Maduranga628/counter-and-collector/Pearl_Weave/Collector_small/collector_small_3D.step

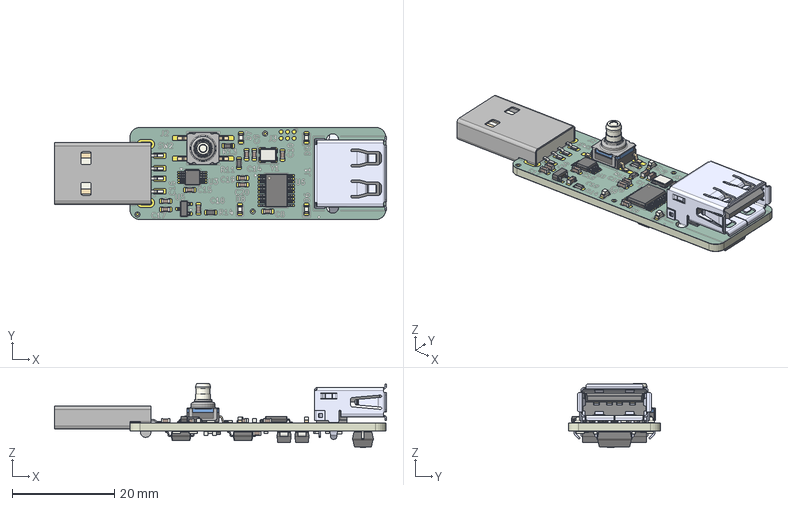
[picture p1: CAD file, 2026-06-02]
Pearl_Weave/Collector_small/collector_small_3D.step
64.8 x 18.0 x 12.6 mm
C_0603_1608Metric x 13
R_0603_1608Metric x 11
LED_0603_1608Metric x 4
SOT-23
USB-A1HSW6
MSOP-10_3x3mm_P0.5mm
USB_A_CNCTech_1001-011-01101_Horizontal
TSSOP-20_4.4x6.5mm_P0.65mm
SW_Push_1P1T_NO_CK_KSC9xxG
Crystal_SMD_3225-4Pin_3.2x2.5mm
D_SOD_523
SOIC-14_3.9x8.7mm_P1.27mm
D_SMA x 3
Fuse_1206_3216Metric x 2
SOIC-8_3.9x4.9mm_P1.27mm
SW_DIP_SPSTx01_Slide_67x41mm_W673mm_P254mm_LowProfile_JPin
Collector_copper
Collector_silkscreen x 2
Collector_soldermask x 2
Collector_PCB
