Maduranga628/counter-and-collector/Pearl_Weave/Counter/Counter.kicad_pcb

## KiCad design Pearl_Weave/Counter/Counter.kicad_pcb (2026-06-02)

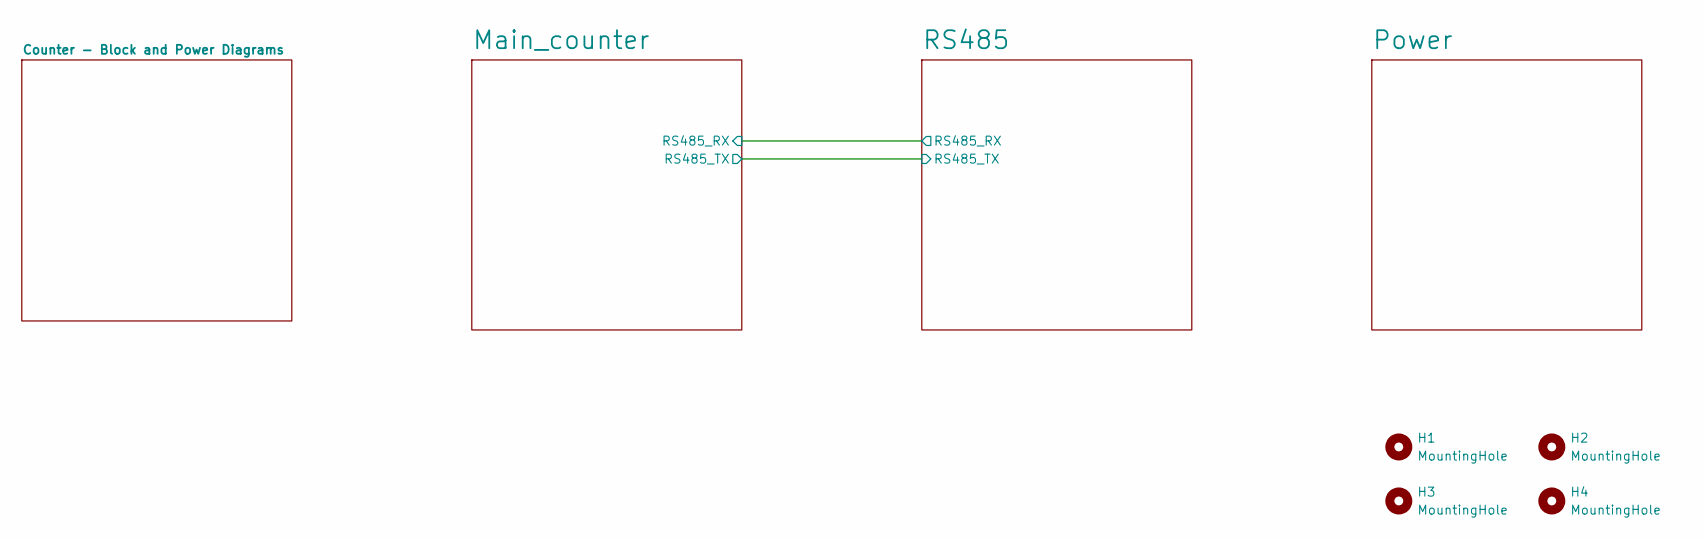
[picture p2: schematic Counter.kicad_sch]

Parts:
H1, H2, H3, H4: MountingHole; MountingHole_3.2mm_M3

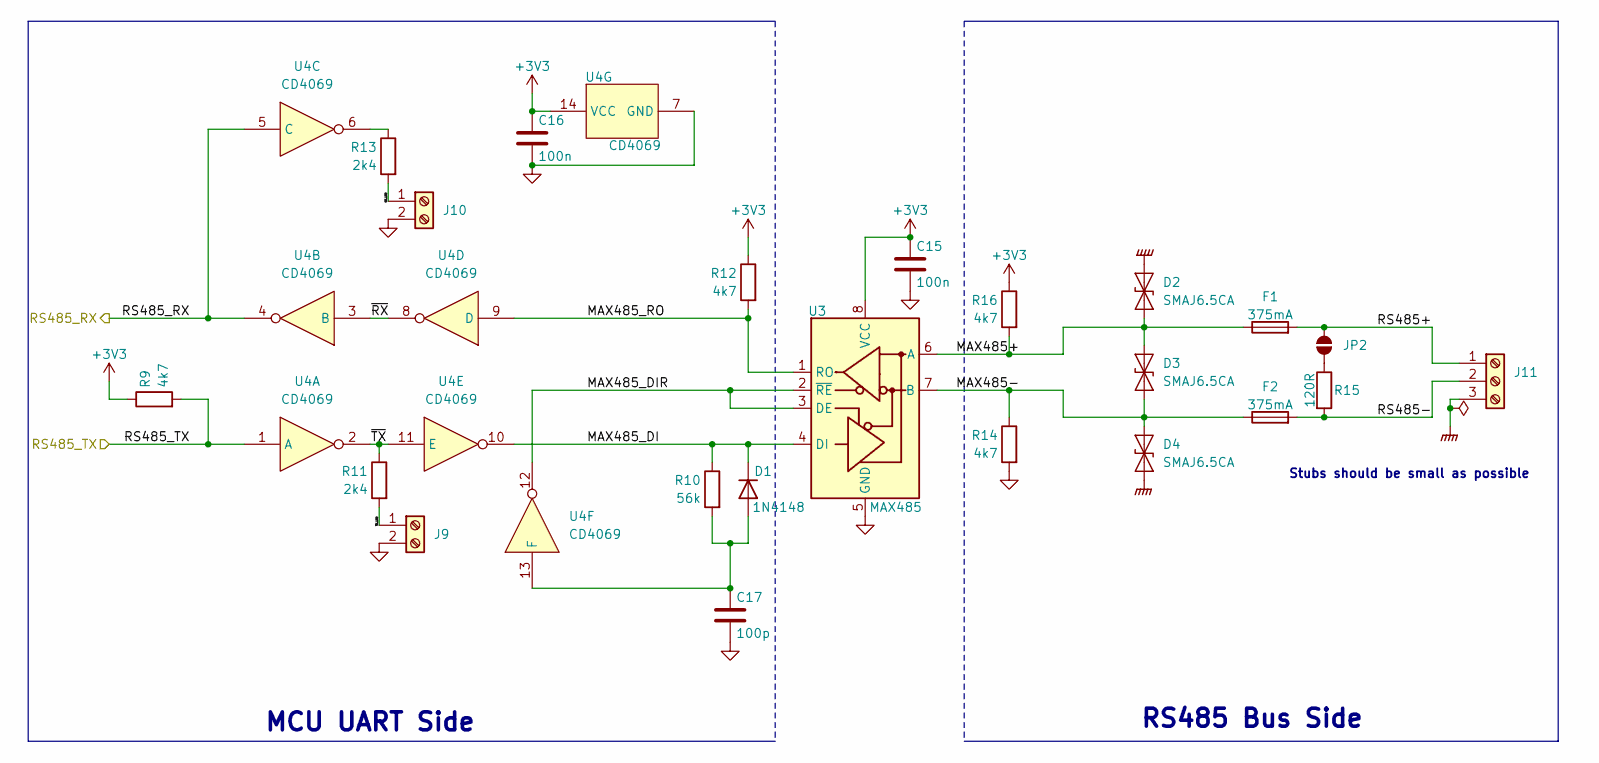
[picture p3: schematic RS485.kicad_sch]

Parts:
C15, C16: 100n; C_0603_1608Metric; Manufacturer Part Number CC0603MRX7R7BB104; LCSC Part Number C2172848
C17: 100p; C_0603_1608Metric; Manufacturer Part Number CC0603FRNPO9BN101; LCSC Part Number C513648
D1: 1N4148; D_SOD-523; Manufacturer Part Number 1N4148WT; LCSC Part Number C917006
D2, D3, D4: SMAJ6.5CA; D_SMA; Manufacturer Part Number SMAJ6.5CA; LCSC Part Number C54318614
F1, F2: 375mA; Fuse_1206_3216Metric; Manufacturer Part Number F12F0.375TH; LCSC Part Number C41398705
J9, J10: Screw_Terminal_01x02; TerminalBlock_Phoenix_MPT-0,5-2-2.54_1x02_P2.54mm_Horizontal
J11: Screw_Terminal_01x03; TerminalBlock_Phoenix_MPT-0,5-3-2.54_1x03_P2.54mm_Horizontal
JP2: SolderJumper_2_Open; SolderJumper-2_P1.3mm_Open_RoundedPad1.0x1.5mm
R9, R12, R14, R16: 4k7; R_0603_1608Metric; Manufacturer Part Number RC0603FR-074K7L; LCSC Part Number C99782
R10: 56k; R_0603_1608Metric; Manufacturer Part Number RC0603FR-0756KL; LCSC Part Number C114630
R11, R13: 2k4; R_0603_1608Metric; Manufacturer Part Number RC0603FR-072K4L; LCSC Part Number C114611
R15: 120R; R_0603_1608Metric; Manufacturer Part Number RC0603FR-07120RL; LCSC Part Number C114640
U3: MAX485; SOIC-8_3.9x4.9mm_P1.27mm; Manufacturer Part Number MAX485CSA+T-JSM; LCSC Part Number C18195057
U4: CD4069; SOIC-14_3.9x8.7mm_P1.27mm; Manufacturer Part Number CD4069; LCSC Part Number C3041279

Connections:
+3V3: C15.1, C16.1, R9.1, R12.1, R16.1, U3.8 (VCC), U4.14 (VCC); also elsewhere on the board
/Main_counter/RS485_RX: U4.4, U4.5 (C); also elsewhere on the board
/Main_counter/RS485_TX: R9.2, U4.1 (A); also elsewhere on the board
/RS485/MAX485+: D2.1 (A1), D3.2 (A2), F1.1, R16.2, U3.6 (A)
/RS485/MAX485-: D3.1 (A1), D4.2 (A2), F2.1, R14.1, U3.7 (B)
/RS485/MAX485_DI: D1.1 (K), R10.1, U3.4 (DI), U4.10
/RS485/MAX485_DIR: U3.2 (~RE), U3.3 (DE), U4.12
/RS485/MAX485_RO: R12.2, U3.1 (RO), U4.9 (D)
/RS485/RS485+: F1.2, J11.1, JP2.2 (B)
/RS485/RS485-: F2.2, J11.2, R15.2
/RS485/RX_LED: J10.1, R13.2
/RS485/TX_LED: J9.1, R11.2
/RS485/~RX: U4.3 (B), U4.8
/RS485/~TX: R11.1, U4.2, U4.11 (E)
GND: C15.2, C16.2, C17.2, J9.2, J10.2, R14.2, U3.5 (GND), U4.7 (GND); also elsewhere on the board
GNDPWR: D2.2 (A2), D4.1 (A1), J11.3
unnamed: C17.1, D1.2 (A), R10.2, U4.13 (F)
unnamed: JP2.1 (A), R15.1
unnamed: R13.1, U4.6

Notes on the sheet:
MCU UART Side
Stubs should be small as possible
RS485 Bus Side

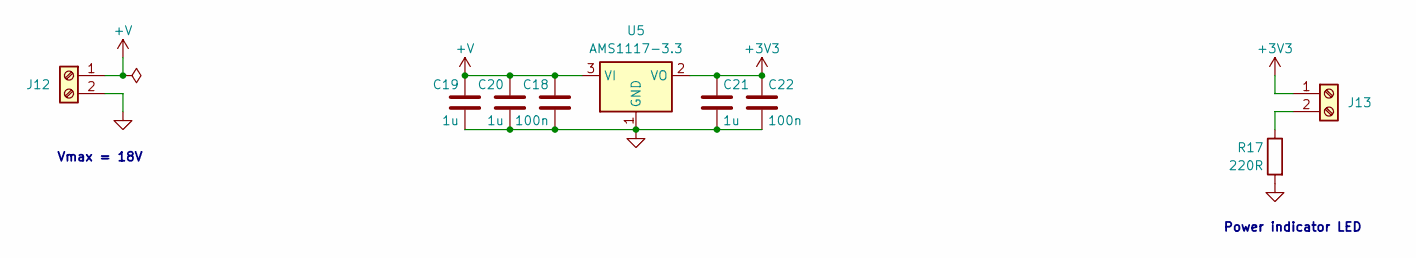
[picture p4: schematic Power.kicad_sch, Power Supply]

Parts:
C18, C22: 100n; C_0603_1608Metric; Manufacturer Part Number CC0603MRX7R7BB104; LCSC Part Number C2172848
C19, C20, C21: 1u; C_0603_1608Metric; Manufacturer Part Number CC0603KRX7R9BB105; LCSC Part Number C14664
J12, J13: Screw_Terminal_01x02; TerminalBlock_Phoenix_MPT-0,5-2-2.54_1x02_P2.54mm_Horizontal
R17: 220R; R_0603_1608Metric; Manufacturer Part Number RC0603JR-07220RL; LCSC Part Number C114683
U5: AMS1117-3.3; SOT-223-3_TabPin2; Manufacturer Part Number AMS1117-3.3(SOT-223); LCSC Part Number C5346136

Connections:
+3V3: C21.1, C22.1, J13.1, U5.2 (VO); also elsewhere on the board
+V: C18.1, C19.1, C20.1, J12.1, U5.3 (VI)
GND: C18.2, C19.2, C20.2, C21.2, C22.2, J12.2, R17.2, U5.1 (GND); also elsewhere on the board
unnamed: J13.2, R17.1

Notes on the sheet:
Power indicator LED
Vmax = 18V

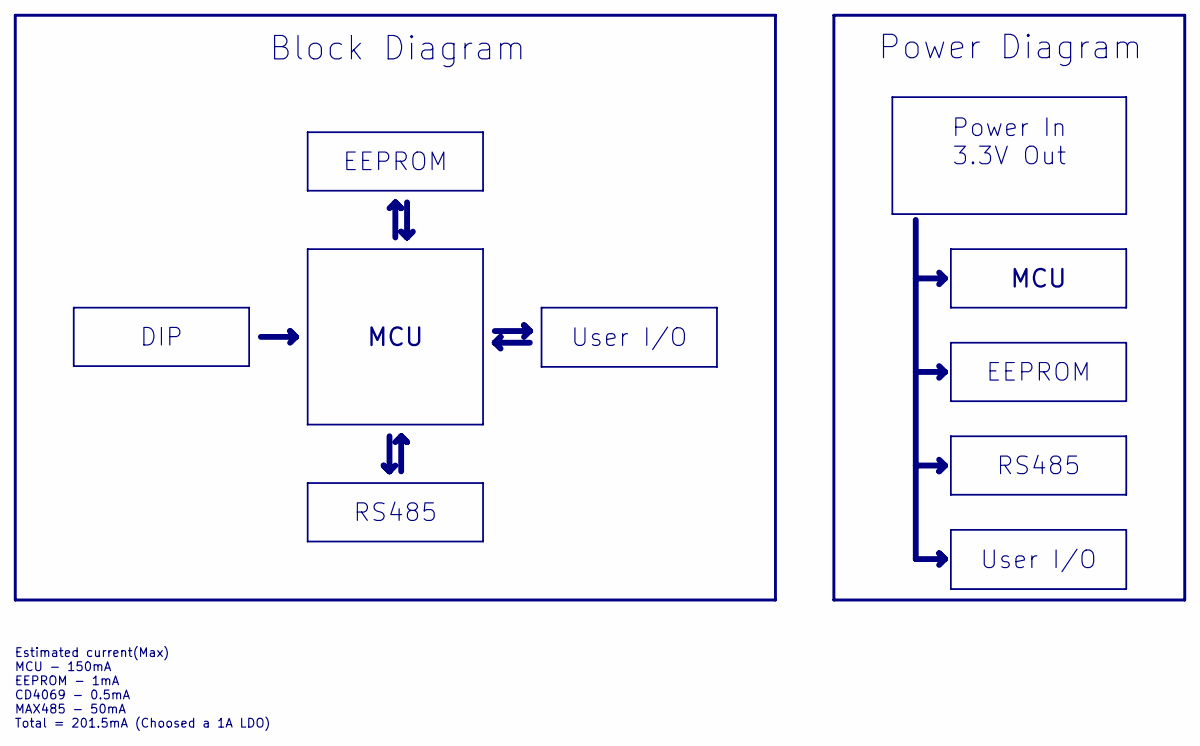
[picture p5: schematic Block and Power Diagrams.kicad_sch]

Notes on the sheet:
Block Diagram
Estimated current(Max) MCU - 150mA EEPROM - 1mA CD4069 - 0.5mA MAX485 - 50mA Total = 201.5mA (Choosed a 1A LDO)
Power Diagram
EEPROM
Power In 3.3V Out
MCU
User I/O
RS485
DIP

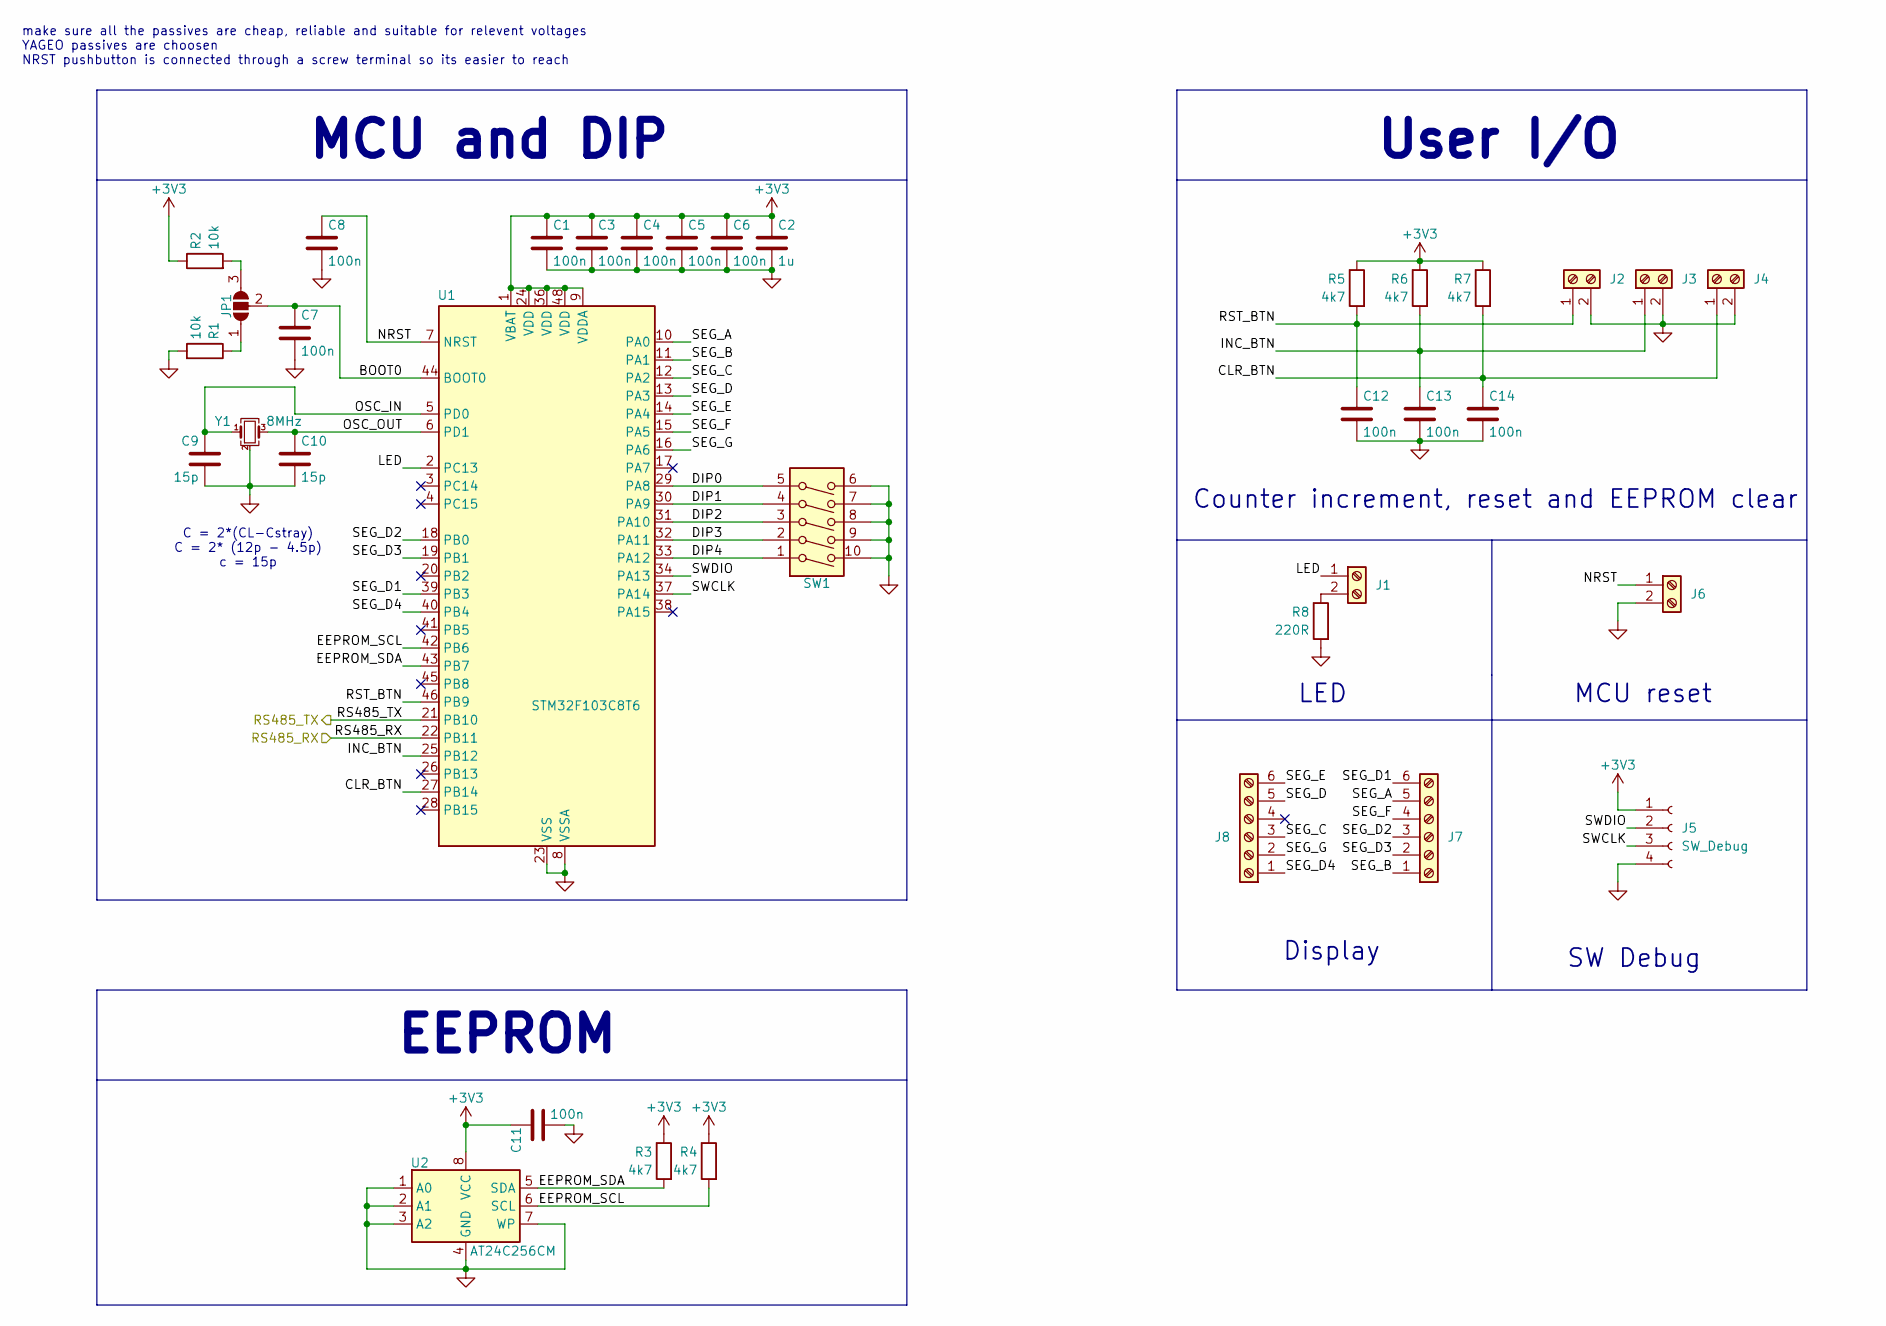
[picture p6: schematic Main_counter.kicad_sch, MCU, EEPROM and User I/O]

Parts:
C1, C3, C4, C5, C6, C7, C8, C11, C12, C13, C14: 100n; C_0603_1608Metric; Manufacturer Part Number CC0603MRX7R7BB104; LCSC Part Number C2172848
C2: 1u; C_0603_1608Metric; Manufacturer Part Number CC0603KRX7R9BB105; LCSC Part Number C14664
C9, C10: 15p; C_0603_1608Metric; Manufacturer Part Number CC0603FRNPO9BN150; LCSC Part Number C519483
J1, J2, J3, J4, J6: Screw_Terminal_01x02; TerminalBlock_Phoenix_MPT-0,5-2-2.54_1x02_P2.54mm_Horizontal
J5: SW_Debug; PinSocket_1x04_P2.54mm_Vertical
J7, J8: Screw_Terminal_01x06; TerminalBlock_Phoenix_MPT-0,5-6-2.54_1x06_P2.54mm_Horizontal
JP1: SolderJumper_3_Open; SolderJumper-3_P1.3mm_Open_RoundedPad1.0x1.5mm
R1, R2: 10k; R_0603_1608Metric; Manufacturer Part Number RC0603JR-0710KL; LCSC Part Number C99198
R3, R4, R5, R6, R7: 4k7; R_0603_1608Metric; Manufacturer Part Number RC0603FR-074K7L; LCSC Part Number C99782
R8: 220R; R_0603_1608Metric; Manufacturer Part Number RC0603JR-07220RL; LCSC Part Number C114683
SW1: SW_DIP_x05; SW_DIP_SPSTx05_Slide_9.78x14.88mm_W7.62mm_P2.54mm
U1: STM32F103C8T6; LQFP-48_7x7mm_P0.5mm
U2: AT24C256CM; SOP-8_3.76x4.96mm_P1.27mm; Manufacturer Part Number AT24C256CM/TR; LCSC Part Number C7432367
Y1: 8MHz; Crystal_SMD_3225-4Pin_3.2x2.5mm; Manufacturer Part Number SX32Y008000BC1T001; LCSC Part Number C20617233

Connections:
+3V3: C1.1, C2.1, C3.1, C4.1, C5.1, C6.1, C11.1, J5.1, R2.1, R3.1, R4.1, R5.1, R6.1, R7.1, U1.1 (VBAT), U1.9 (VDDA), U1.24 (VDD), U1.36 (VDD), U1.48 (VDD), U2.8 (VCC); also elsewhere on the board
/Main_counter/BOOT0: C7.1, JP1.2 (C), U1.44 (BOOT0)
/Main_counter/CLR_BTN: C14.1, J4.1, R7.2, U1.27 (PB14)
/Main_counter/DIP0: SW1.5, U1.29 (PA8)
/Main_counter/DIP1: SW1.4, U1.30 (PA9)
/Main_counter/DIP2: SW1.3, U1.31 (PA10)
/Main_counter/DIP3: SW1.2, U1.32 (PA11)
/Main_counter/DIP4: SW1.1, U1.33 (PA12)
/Main_counter/EEPROM_SCL: R4.2, U1.42 (PB6), U2.6 (SCL)
/Main_counter/EEPROM_SDA: R3.2, U1.43 (PB7), U2.5 (SDA)
/Main_counter/INC_BTN: C13.1, J3.1, R6.2, U1.25 (PB12)
/Main_counter/LED: J1.1, U1.2 (PC13)
/Main_counter/NRST: C8.1, J6.1, U1.7 (NRST)
/Main_counter/OSC_IN: C9.1, U1.5 (PD0), Y1.1
/Main_counter/OSC_OUT: C10.1, U1.6 (PD1), Y1.3
/Main_counter/RS485_RX: U1.22 (PB11); also elsewhere on the board
/Main_counter/RS485_TX: U1.21 (PB10); also elsewhere on the board
/Main_counter/RST_BTN: C12.1, J2.1, R5.2, U1.46 (PB9)
/Main_counter/SEG_A: J7.5, U1.10 (PA0)
/Main_counter/SEG_B: J7.1, U1.11 (PA1)
/Main_counter/SEG_C: J8.3, U1.12 (PA2)
/Main_counter/SEG_D: J8.5, U1.13 (PA3)
/Main_counter/SEG_D1: J7.6, U1.39 (PB3)
/Main_counter/SEG_D2: J7.3, U1.18 (PB0)
/Main_counter/SEG_D3: J7.2, U1.19 (PB1)
/Main_counter/SEG_D4: J8.1, U1.40 (PB4)
/Main_counter/SEG_E: J8.6, U1.14 (PA4)
/Main_counter/SEG_F: J7.4, U1.15 (PA5)
/Main_counter/SEG_G: J8.2, U1.16 (PA6)
/Main_counter/SWCLK: J5.3, U1.37 (PA14)
/Main_counter/SWDIO: J5.2, U1.34 (PA13)
GND: C1.2, C2.2, C3.2, C4.2, C5.2, C6.2, C7.2, C8.2, C9.2, C10.2, C11.2, C12.2, C13.2, C14.2, J2.2, J3.2, J4.2, J5.4, J6.2, R1.2, R8.2, SW1.6, SW1.7, SW1.8, SW1.9, SW1.10, U1.8 (VSSA), U1.23 (VSS), U1.35 (VSS), U1.47 (VSS), U2.1 (A0), U2.2 (A1), U2.3 (A2), U2.4 (GND), U2.7 (WP), Y1.2 (G), Y1.4 (G); also elsewhere on the board
unnamed: J1.2, R8.1
unnamed: JP1.1 (A), R1.1
unnamed: JP1.3 (B), R2.2

Notes on the sheet:
User I/O
Counter increment, reset and EEPROM clear
C = 2*(CL-Cstray) C = 2* (12p - 4.5p) c = 15p
SW Debug
Display
MCU and DIP
EEPROM
make sure all the passives are cheap, reliable and suitable for relevent voltages YAGEO passives are choosen NRST pushbutton is connected through a screw terminal so its easier to reach
LED
MCU reset

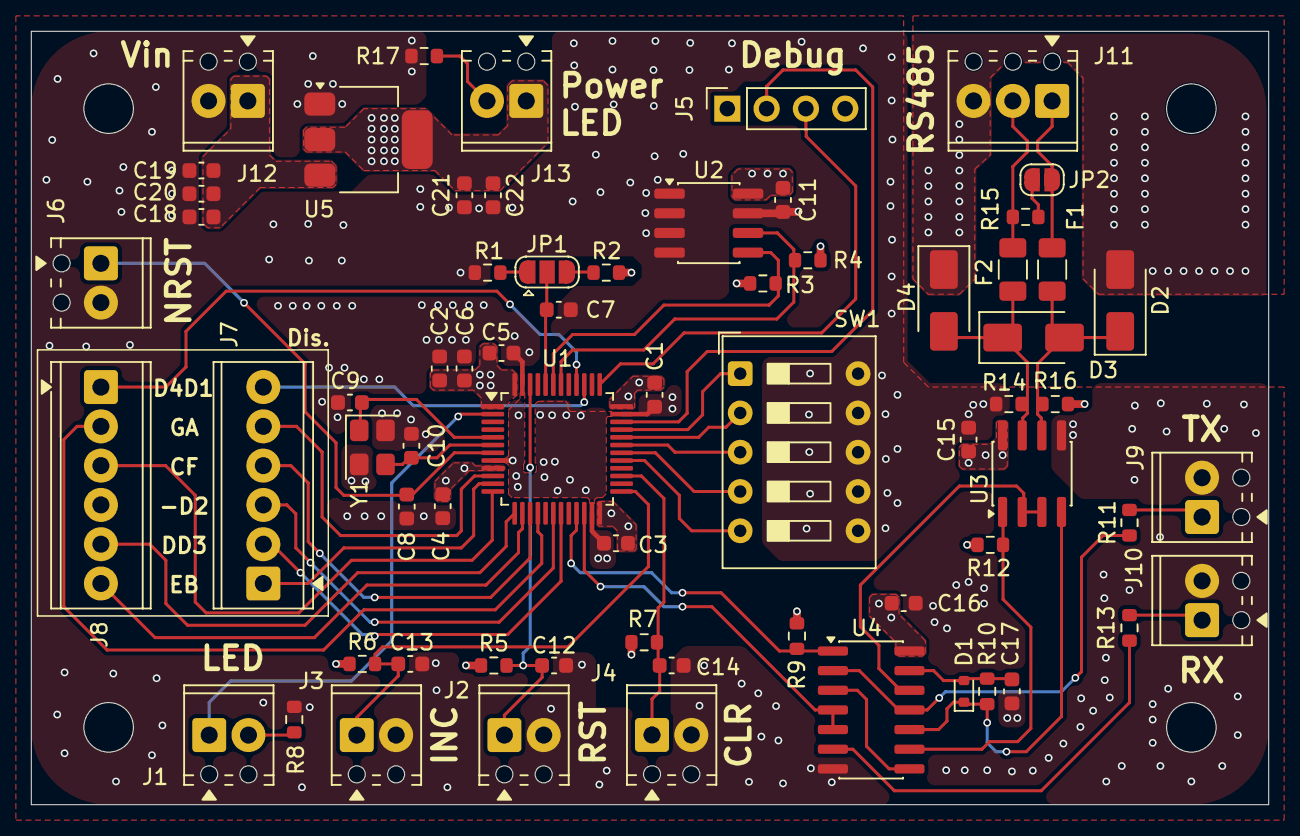
[picture p7: board Counter.kicad_pcb from above]

Board: 4 copper layers, 80.0 x 50.0 mm, 71 parts (0 on the bottom side), 52 nets.
