Maduranga628/counter-and-collector/Pearl_Weave/Collector/Collector.kicad_pcb

## KiCad design Pearl_Weave/Collector/Collector.kicad_pcb (2026-06-02)

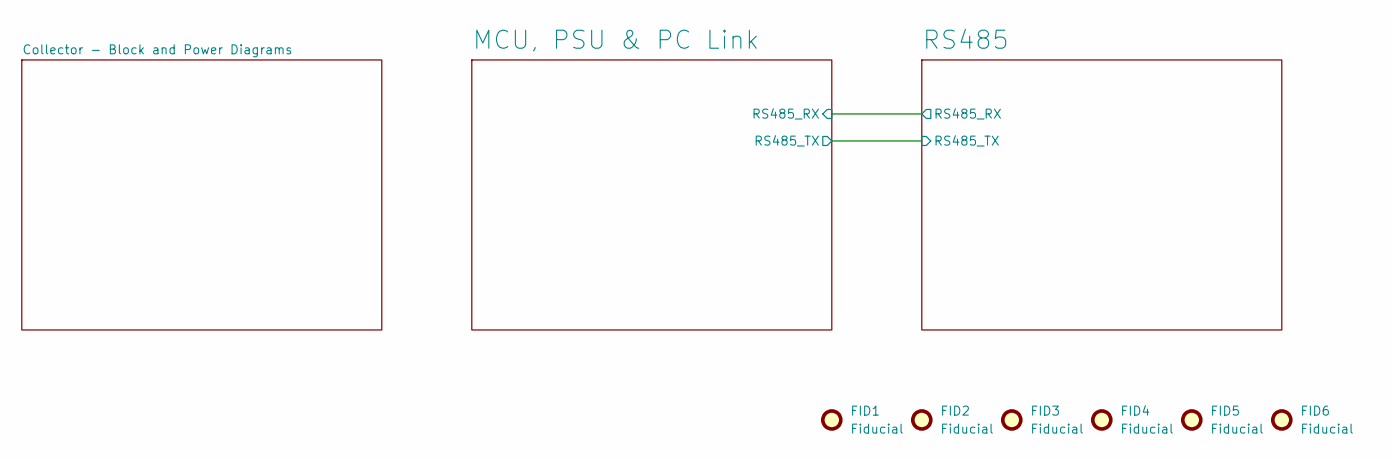
[picture p8: schematic Collector.kicad_sch]

Parts:
FID1, FID2, FID3, FID4, FID5, FID6: Fiducial; Fiducial_0.5mm_Mask1mm

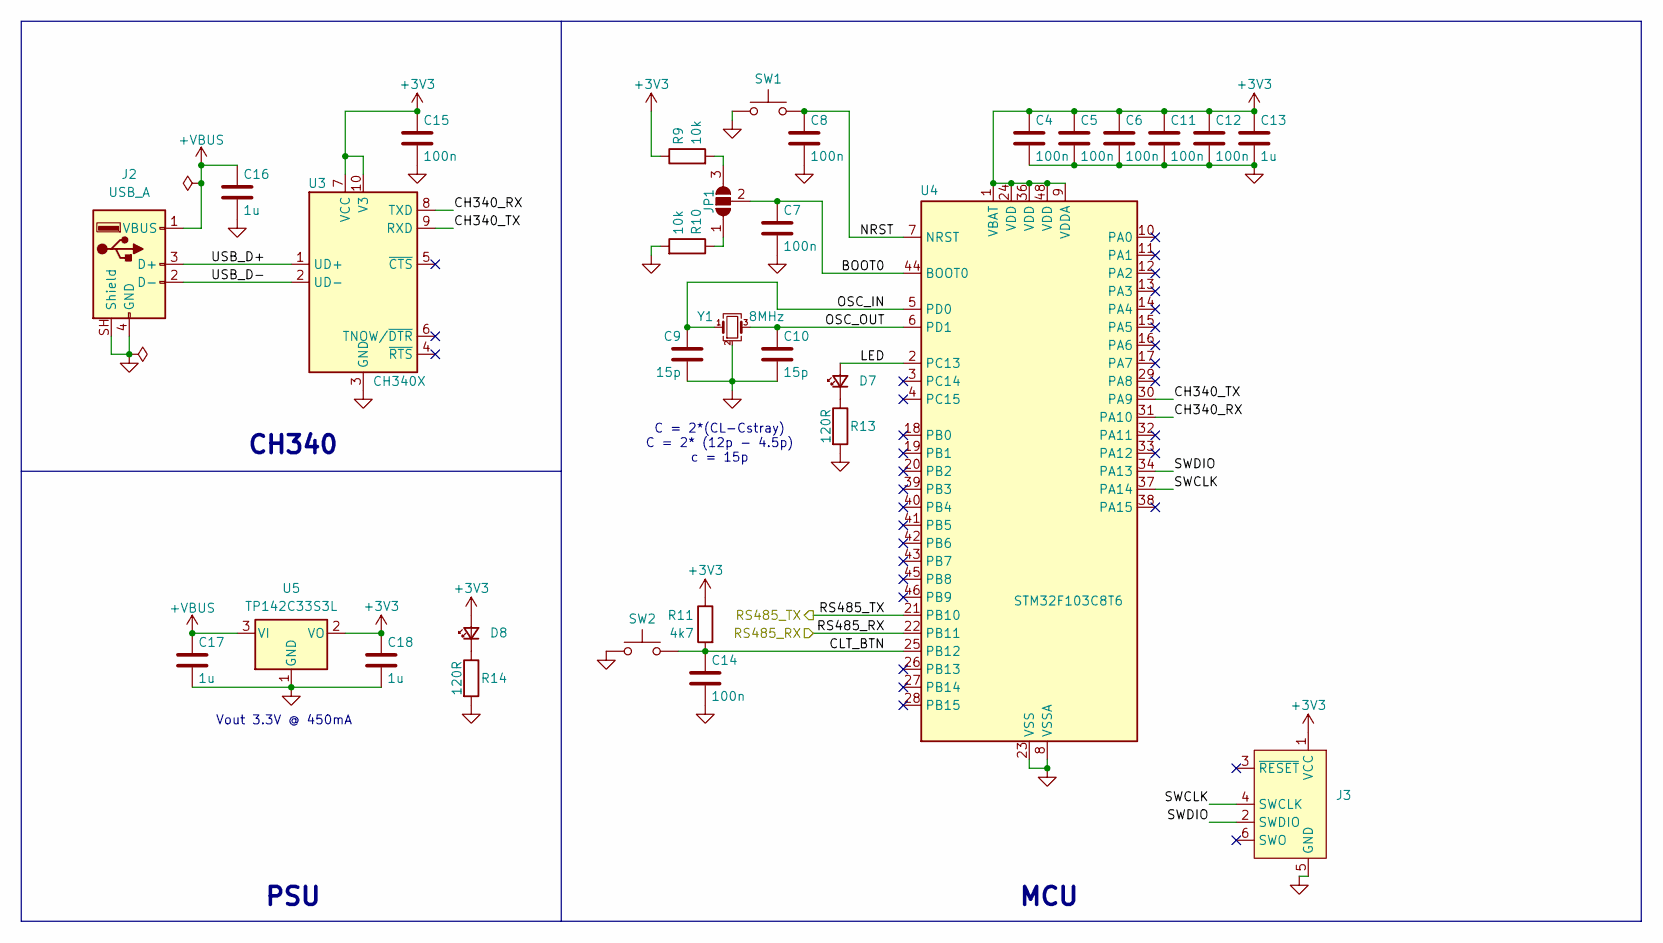
[picture p9: schematic MCU_PSU_PC_Link.kicad_sch, MCU, PSU and PC Link]

Parts:
C4, C5, C6, C7, C8, C11, C12, C14, C15: 100n; C_0603_1608Metric; Manufacturer Part Number CC0603MRX7R7BB104; LCSC Part Number C2172848
C9, C10: 15p; C_0603_1608Metric; Manufacturer Part Number CC0603FRNPO9BN150; LCSC Part Number C519483
C13, C16, C17, C18: 1u; C_0603_1608Metric; Manufacturer Part Number CC0603KRX7R9BB105; LCSC Part Number C14664
D7: LED_Small; LED_0603_1608Metric; Manufacturer Part Number YLED0603G; LCSC Part Number C19273151
D8: LED_Small; LED_0603_1608Metric; Manufacturer Part Number YLED0603R; LCSC Part Number C19171390
J2: USB_A; USB_A_CNCTech_1001-011-01101_Horizontal
J3: Conn_ARM_SWD_TagConnect_TC2030; Tag-Connect_TC2030-IDC-FP_2x03_P1.27mm_Vertical
JP1: SolderJumper_3_Open; SolderJumper-3_P1.3mm_Open_RoundedPad1.0x1.5mm
R9, R10: 10k; R_0603_1608Metric; Manufacturer Part Number RC0603JR-0710KL; LCSC Part Number C99198
R11: 4k7; R_0603_1608Metric; Manufacturer Part Number RC0603FR-074K7L; LCSC Part Number C99782
R13, R14: 120R; R_0603_1608Metric; Manufacturer Part Number RC0603FR-07120RL; LCSC Part Number C114640
SW1: SW_Push; SW_DIP_SPSTx01_Slide_6.7x4.1mm_W6.73mm_P2.54mm_LowProfile_J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; Manufacturer Part Number R4A25211L; LCSC Part Number C49393629
SW2: SW_Push; SW_Push_1P1T_NO_CK_KSC9xxG
U3: CH340X; MSOP-10_3x3mm_P0.5mm; Manufacturer Part Number CH340X; LCSC Part Number C3035748
U4: STM32F103C8T6; LQFP-48_7x7mm_P0.5mm
U5: TP142C33S3L; SOT-23; Manufacturer Part Number TP142C33S3L; LCSC Part Number C3021129
Y1: 8MHz; Crystal_SMD_3225-4Pin_3.2x2.5mm; Manufacturer Part Number SX32Y008000BC1T001; LCSC Part Number C20617233

Connections:
+3V3: C4.1, C5.1, C6.1, C11.1, C12.1, C13.1, C15.1, C18.1, D8.2 (A), J3.1 (VCC), R9.1, R11.1, U3.7 (VCC), U3.10 (V3), U4.1 (VBAT), U4.9 (VDDA), U4.24 (VDD), U4.36 (VDD), U4.48 (VDD), U5.2 (VO); also elsewhere on the board
+VBUS: C16.1, C17.1, J2.1 (VBUS), U5.3 (VI)
/MCU, PSU & PC Link/BOOT0: C7.1, JP1.2 (C), U4.44 (BOOT0)
/MCU, PSU & PC Link/CH340_RX: U3.8 (TXD), U4.31 (PA10)
/MCU, PSU & PC Link/CH340_TX: U3.9 (RXD), U4.30 (PA9)
/MCU, PSU & PC Link/CLT_BTN: C14.1, R11.2, SW2.2, U4.25 (PB12)
/MCU, PSU & PC Link/LED: D7.2 (A), U4.2 (PC13)
/MCU, PSU & PC Link/NRST: C8.1, SW1.2, U4.7 (NRST)
/MCU, PSU & PC Link/OSC_IN: C9.1, U4.5 (PD0), Y1.1
/MCU, PSU & PC Link/OSC_OUT: C10.1, U4.6 (PD1), Y1.3
/MCU, PSU & PC Link/RS485_RX: U4.22 (PB11); also elsewhere on the board
/MCU, PSU & PC Link/RS485_TX: U4.21 (PB10); also elsewhere on the board
/MCU, PSU & PC Link/SWCLK: J3.4 (SWCLK), U4.37 (PA14)
/MCU, PSU & PC Link/SWDIO: J3.2 (SWDIO), U4.34 (PA13)
/MCU, PSU & PC Link/USB_D+: J2.3 (D+), U3.1 (UD+)
/MCU, PSU & PC Link/USB_D-: J2.2 (D-), U3.2 (UD-)
GND: C4.2, C5.2, C6.2, C7.2, C8.2, C9.2, C10.2, C11.2, C12.2, C13.2, C14.2, C15.2, C16.2, C17.2, C18.2, J2.4 (GND), J2.SH (Shield), J3.5 (GND), R10.2, R13.2, R14.2, SW1.1, SW2.1, U3.3 (GND), U4.8 (VSSA), U4.23 (VSS), U4.35 (VSS), U4.47 (VSS), U5.1 (GND), Y1.2 (G), Y1.4 (G); also elsewhere on the board
unnamed: D7.1 (K), R13.1
unnamed: D8.1 (K), R14.1
unnamed: JP1.1 (A), R10.1
unnamed: JP1.3 (B), R9.2

Notes on the sheet:
PSU
CH340
Vout 3.3V @ 450mA
MCU
C = 2*(CL-Cstray) C = 2* (12p - 4.5p) c = 15p

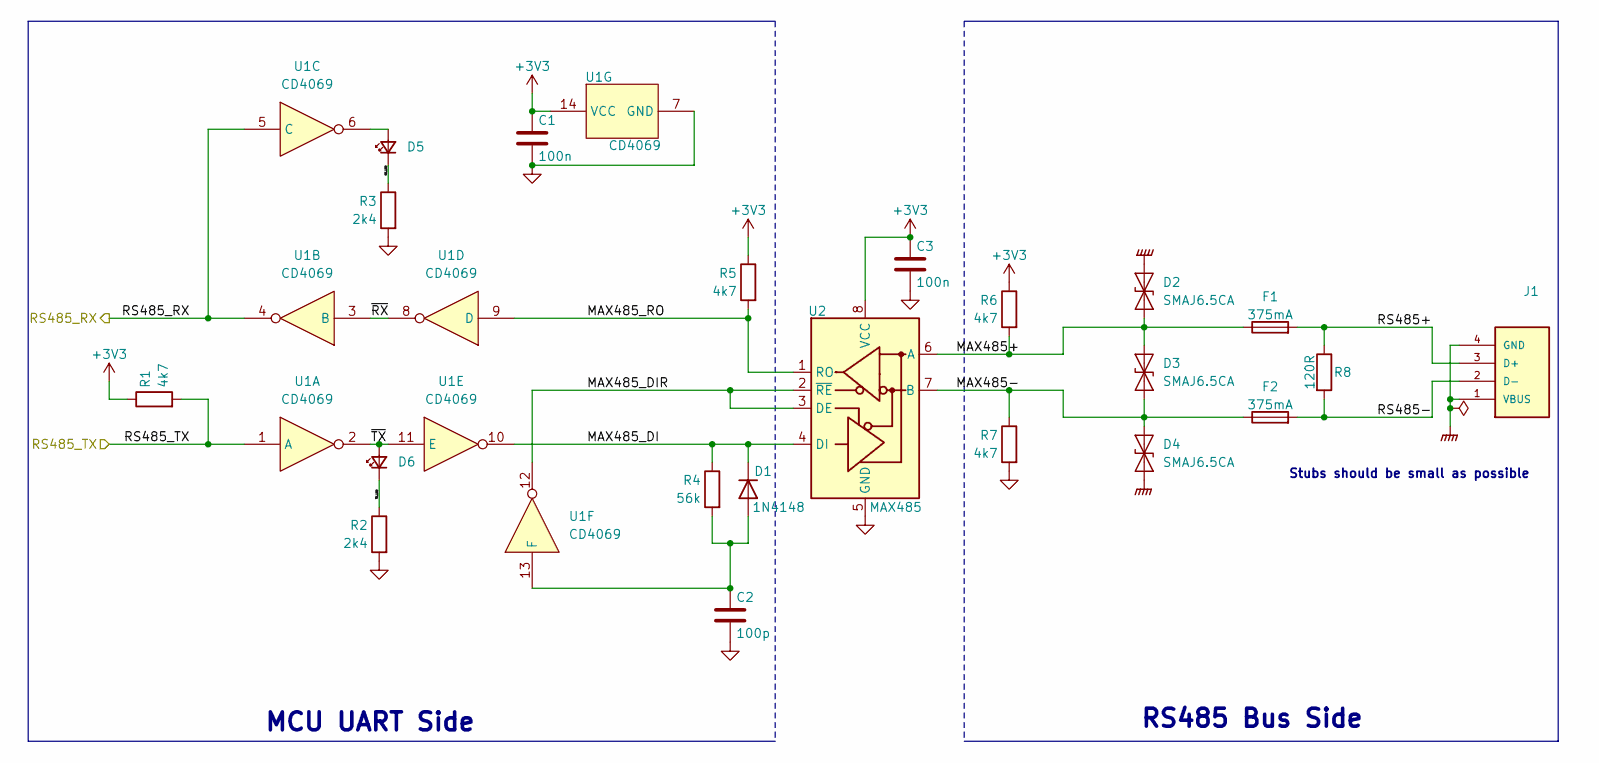
[picture p10: schematic RS485.kicad_sch]

Parts:
C1, C3: 100n; C_0603_1608Metric; Manufacturer Part Number CC0603MRX7R7BB104; LCSC Part Number C2172848
C2: 100p; C_0603_1608Metric; Manufacturer Part Number CC0603FRNPO9BN101; LCSC Part Number C513648
D1: 1N4148; D_SOD-523; Manufacturer Part Number 1N4148WT; LCSC Part Number C917006
D2, D3, D4: SMAJ6.5CA; D_SMA; Manufacturer Part Number SMAJ6.5CA; LCSC Part Number C54318614
D5, D6: LED_Small; LED_0603_1608Metric; Manufacturer Part Number YLED0603R; LCSC Part Number C19171390
F1, F2: 375mA; Fuse_1206_3216Metric; Manufacturer Part Number F12F0.375TH; LCSC Part Number C41398705
J1: USB-A1HSW6; OST_USB-A1HSW6; PARTREV A
R1, R5, R6, R7: 4k7; R_0603_1608Metric; Manufacturer Part Number RC0603FR-074K7L; LCSC Part Number C99782
R2, R3: 2k4; R_0603_1608Metric; Manufacturer Part Number RC0603FR-072K4L; LCSC Part Number C114611
R4: 56k; R_0603_1608Metric; Manufacturer Part Number RC0603FR-0756KL; LCSC Part Number C114630
R8: 120R; R_0603_1608Metric; Manufacturer Part Number RC0603FR-07120RL; LCSC Part Number C114640
U1: CD4069; SOIC-14_3.9x8.7mm_P1.27mm; Manufacturer Part Number CD4069; LCSC Part Number C3041279
U2: MAX485; SOIC-8_3.9x4.9mm_P1.27mm; Manufacturer Part Number MAX485CSA+T-JSM; LCSC Part Number C18195057

Connections:
+3V3: C1.1, C3.1, R1.1, R5.1, R6.1, U1.14 (VCC), U2.8 (VCC); also elsewhere on the board
/MCU, PSU & PC Link/RS485_RX: U1.4, U1.5 (C); also elsewhere on the board
/MCU, PSU & PC Link/RS485_TX: R1.2, U1.1 (A); also elsewhere on the board
/RS485/MAX485+: D2.1 (A1), D3.2 (A2), F1.1, R6.2, U2.6 (A)
/RS485/MAX485-: D3.1 (A1), D4.2 (A2), F2.1, R7.1, U2.7 (B)
/RS485/MAX485_DI: D1.1 (K), R4.1, U1.10, U2.4 (DI)
/RS485/MAX485_DIR: U1.12, U2.2 (~RE), U2.3 (DE)
/RS485/MAX485_RO: R5.2, U1.9 (D), U2.1 (RO)
/RS485/RS485+: F1.2, J1.3 (D+), R8.1
/RS485/RS485-: F2.2, J1.2 (D-), R8.2
/RS485/RX_LED: D5.1 (K), R3.1
/RS485/TX_LED: D6.1 (K), R2.1
/RS485/~RX: U1.3 (B), U1.8
/RS485/~TX: D6.2 (A), U1.2, U1.11 (E)
GND: C1.2, C2.2, C3.2, R2.2, R3.2, R7.2, U1.7 (GND), U2.5 (GND); also elsewhere on the board
GNDPWR: D2.2 (A2), D4.1 (A1), J1.1 (VBUS), J1.4 (GND)
unnamed: C2.1, D1.2 (A), R4.2, U1.13 (F)
unnamed: D5.2 (A), U1.6

Notes on the sheet:
MCU UART Side
Stubs should be small as possible
RS485 Bus Side

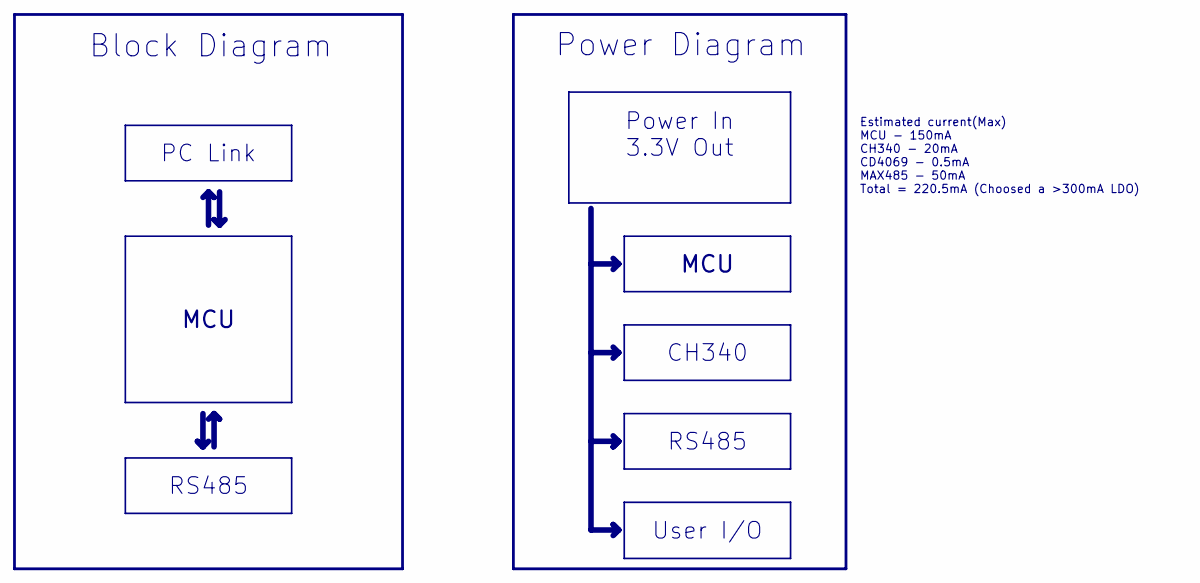
[picture p11: schematic Block and Power Diagrams.kicad_sch]

Notes on the sheet:
Power Diagram
Block Diagram
Estimated current(Max) MCU - 150mA CH340 - 20mA CD4069 - 0.5mA MAX485 - 50mA Total = 220.5mA (Choosed a >300mA LDO)
User I/O
RS485
MCU
CH340
Power In 3.3V Out
PC Link

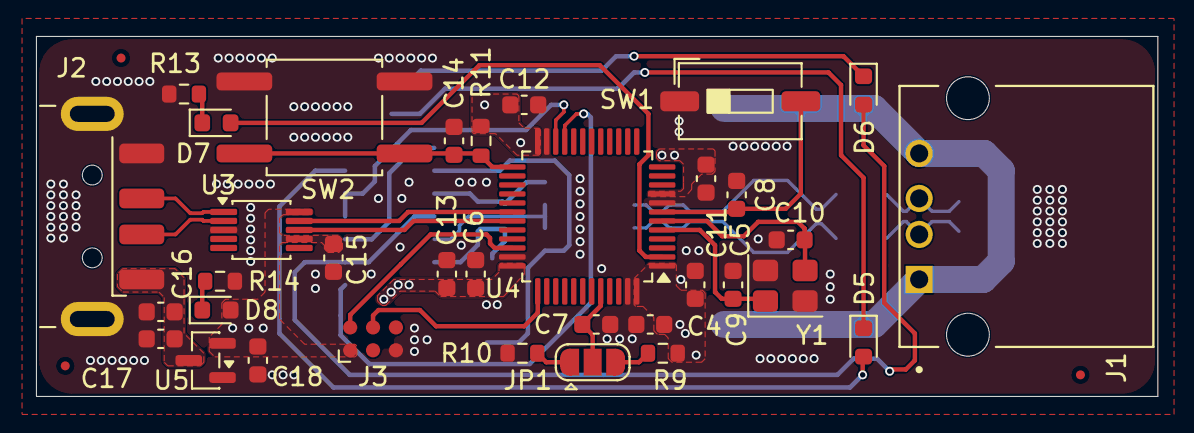
[picture p12: board Collector.kicad_pcb from above]

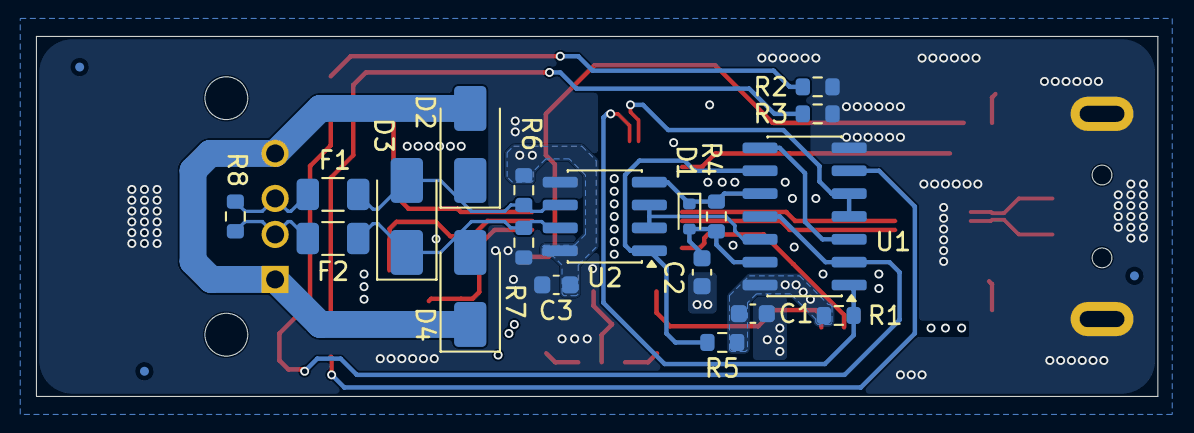
[picture p13: board Collector.kicad_pcb from below]

Board: 4 copper layers, 62.3 x 20.0 mm, 59 parts (22 on the bottom side), 35 nets.
